mike-rankin/ESP32_VL53L5CX/Images/Board3.jpg

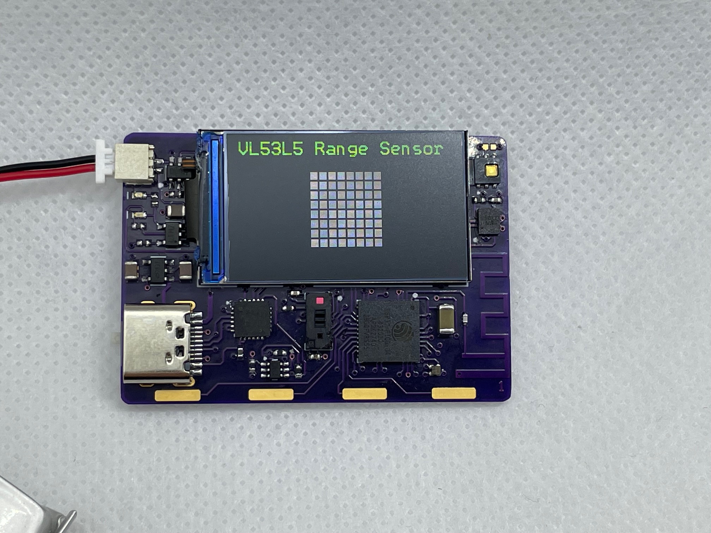
Images/Board3.jpg
