mike-rankin/ESP32_VL53L5CX/Images/Board2.jpg

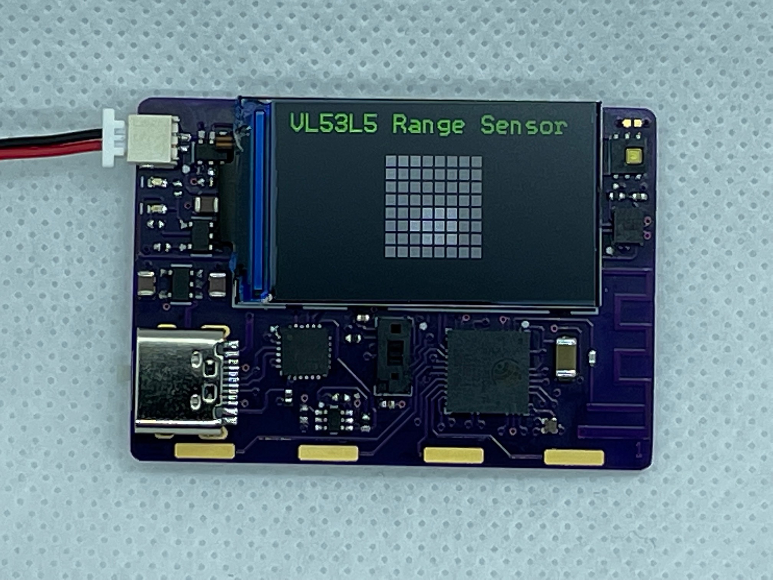
Images/Board2.jpg
