mike-rankin/ESP32_VL53L5CX/README.md

# ESP32_VL53L5CX
Small dev board for the STMicro VL53L5CX Sensor

Board3

The VL53L5CX from STMicro is an interesting multi zone range sensor. I've been using the older VL53L0CX for years as a large distance touchless sensor and range sensor but the new VL53L5CX does the same job but can see the range of several different objects all at the same time broken down into zones. These values can be displayed as pixels showing as a very low resolution camera.

Arduino library here:https://github.com/simondlevy/VL53L5
ESp32 library tweaks needed here: https://github.com/simondlevy/VL53L5/issues/5

Zones

Zones2

See a video of it in action here:https://youtu.be/wSQc9fxhErk
