mike-rankin/ESP32_VL53L5CX/Images/Board1.jpg

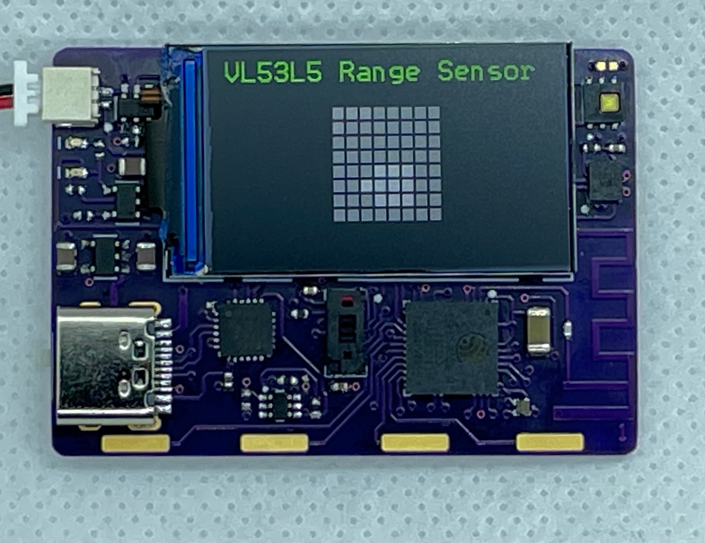
Images/Board1.jpg
