mike-rankin/ESP32_VL53L5CX/Images/VL53L5CX.jpg

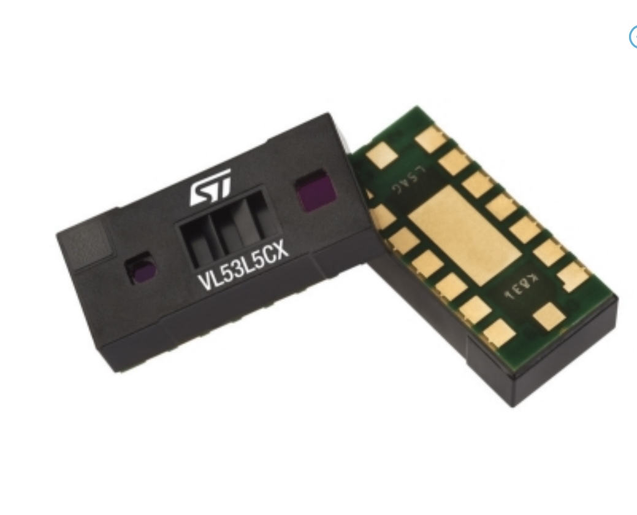
Images/VL53L5CX.jpg
