mike-rankin/ESP32_VL53L5CX/Images/Zones2.jpg

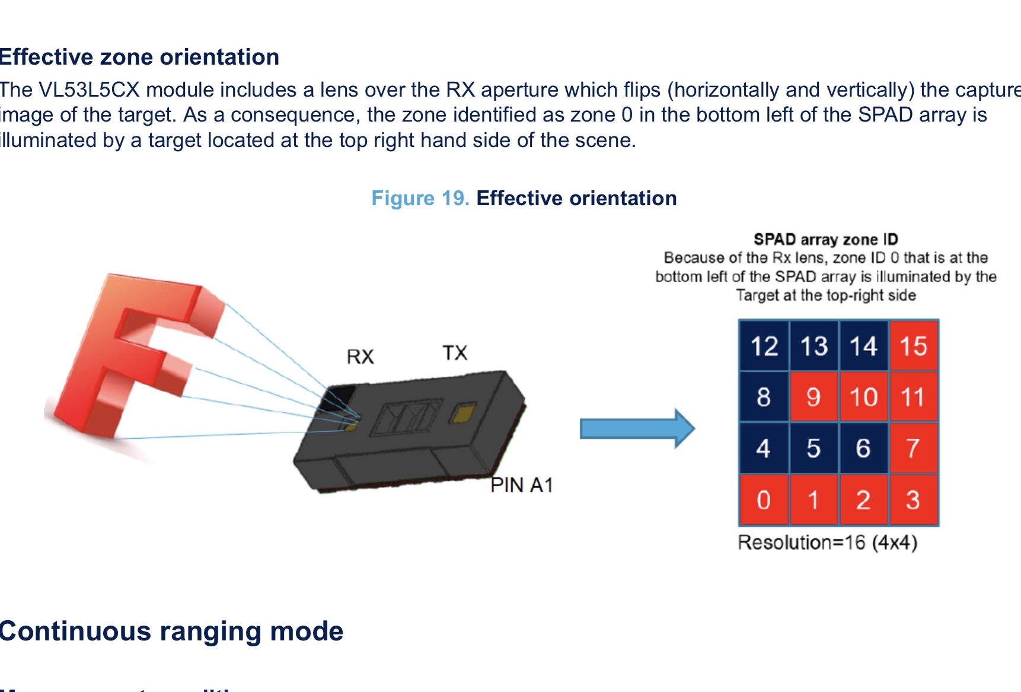
Images/Zones2.jpg
