mike-rankin/ESP32_VL53L5CX/Images/Zones.jpg

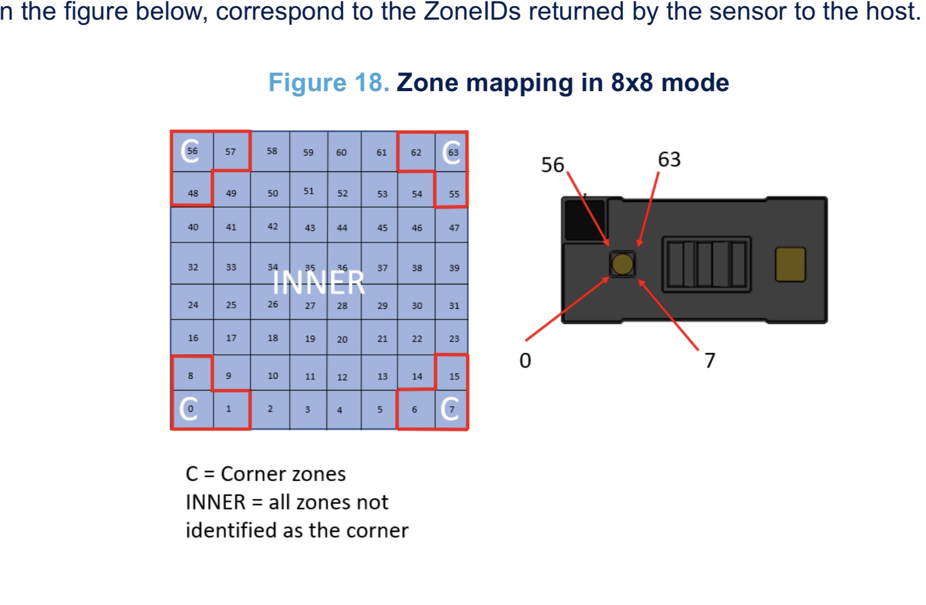
Images/Zones.jpg
