mike-rankin/ESP32_VL53L5CX/PCB/Parts_List_Rev1.xlsx

Designator | Quantity | Vendor | PartNumber | Description | Manufacturer | Value
C1, C2, C4, C5, C10, C14, C19 | 7 | LCSC | C344190 | CAP 0.1uF 0402 | CCTC | 0.1uF
C3 | 1 | LCSC | C147344 | CAP 1.5pF 0402 | Dafron | 1.5pF
C6 | 1 | LCSC | C87164 | CAP 100uF 6.3V 1206 | Taiyo Yuden | 100uF
C7, C9, C13, C15 | 4 | LCSC | C307520 | CAP 10uF 0805 | Samsung | 10uF
C8 | 1 | LCSC | C385897 | CAP 4.7uF 0805 | Taiyo Yunden | 4.7uF
C18 | 1 | LCSC | C83063 | CAP 1uF 16V 0402 | Walsin | 1uF
D1 | 1 | LCSC | C475717 | DIODE SCHOTTKY 20V 500MA SOD123 | CJ | MBR0520
D2 | 1 | LCSC | C364556 | LED RED 0603 |  | Red Led
D3 | 1 | LCSC | C158099 | LED,RGB LED,SMD,RoHS | Foshan | RGB Led
D4 | 1 | LCSC | C74338 | LED Green 0402 |  | Green Led
J2 | 1 | LCSC | C165948 | CONN RECPT USB-C | KHE | USB-C
Q1 | 1 | LCSC | BC847S | TRANS 2NPN 44V 0.1A SC-70-6 | Changjiang | 2NPN
Q2 | 1 | LCSC | C75469 | MOSFET P-CH 20V 2A SOT-23 | On Semi | Mosfet P-CH
Q3 | 1 | LCSC | C668969 | TRANSISTOR NPN SOT23 | Micro Commercial | MMBT3904-TP
Q4 | 1 | LCSC | C16052 | MOSFET 2N-CH 20V 6A TSSOP-8L | Fortune | FS8205A
R1, R3, R5, R6, R7, R19 | 6 | LCSC | C258091 | RES 10K 0402 | Guangdong | 10K
R2, R8, R9, R10, R20 | 5 | LCSC | C106235 | RES 1K 0402 | Yageo | 1K
R4 | 1 | LCSC | C8329 | RES 43K 0402 | Uniroyal | 43K
R11 | 1 | LCSC | C25741 | RES 100K 0402 | Uniroyal Elec | 100K
R12, R13 | 2 | LCSC | C100291 | RES 2K 0402 | LIZ Elec | 2K
R14 | 1 | LCSC | C100139 | RES 4.7K 0402 | LIZ Elec | 4.7K
R15 | 1 | LCSC | C25092 | RES 22R 0402 | Uniroyal | 22R
R16, R18 | 2 | LCSC | C965250 | RES 5.1K 0402 | Uni-Royal | 5.1K
R17 | 1 | LCSC | C106232 | RES 100R 0402 | Yageo | 100R
R21 | 1 | LCSC | C100310 | RES 22K 0402 | LIZ Elec | 22K
R22, R23, R24, R25 | 4 | LCSC | C25792 | RES 47K 0402 | Uni-Royal | 47K
S1 | 1 | LCSC | C128955 | SWITCH SLIDE SMD | Korean Hroparts Elec | SWITCH SLIDE
U1 | 1 | LCSC | C47742 | IC BRIDGE USB TO UART 24QFN | Silicon Labs | CP2104N
U2 | 1 | LCSC | C193707 | RF Transceiver ICs QFN-48_7x7x05P RoHS | Espressif | ESP32-PICO-D4
U4 | 1 | LCSC | C164106 | IC LDO 3.3V 0.5A SOT23-5 | Holtek | HT7833
U5 | 1 | LCSC | C258510 | Charger IC Lithium-Ion/Polymer SOT23-5 | Techfuse | SL4054ST25P
U6 | 1 | LCSC | LSM6DS3TR | IMU ACCEL/GYRO I2C/SPI 14VFLGA | ST MICRO | LSM6DS3
U7 | 1 | LCSC | C82227 | Humidity/Temperature Sensor | Texas Instruments | HDC1080DMBT
U8 | 1 | LCSC | C351410 | IC LITHIUM BATT PROTECT SOT-23-6L | PUOLOP | DW01A
U9 | 1 | Digi-Key | VL53L5CXV0GC/1 | IC,LASER SENSOR,17pin | ST MICRO | VL53L5CX
X1 | 1 | BuyDisplay | ER-TFT1.14-1 | 1.14 INCH TFT GLASS COLOR | BuyDisplay | TFT_1.14"
