mike-rankin/ESP32_VL53L5CX/PCB/Schematic_Rev1.pdf

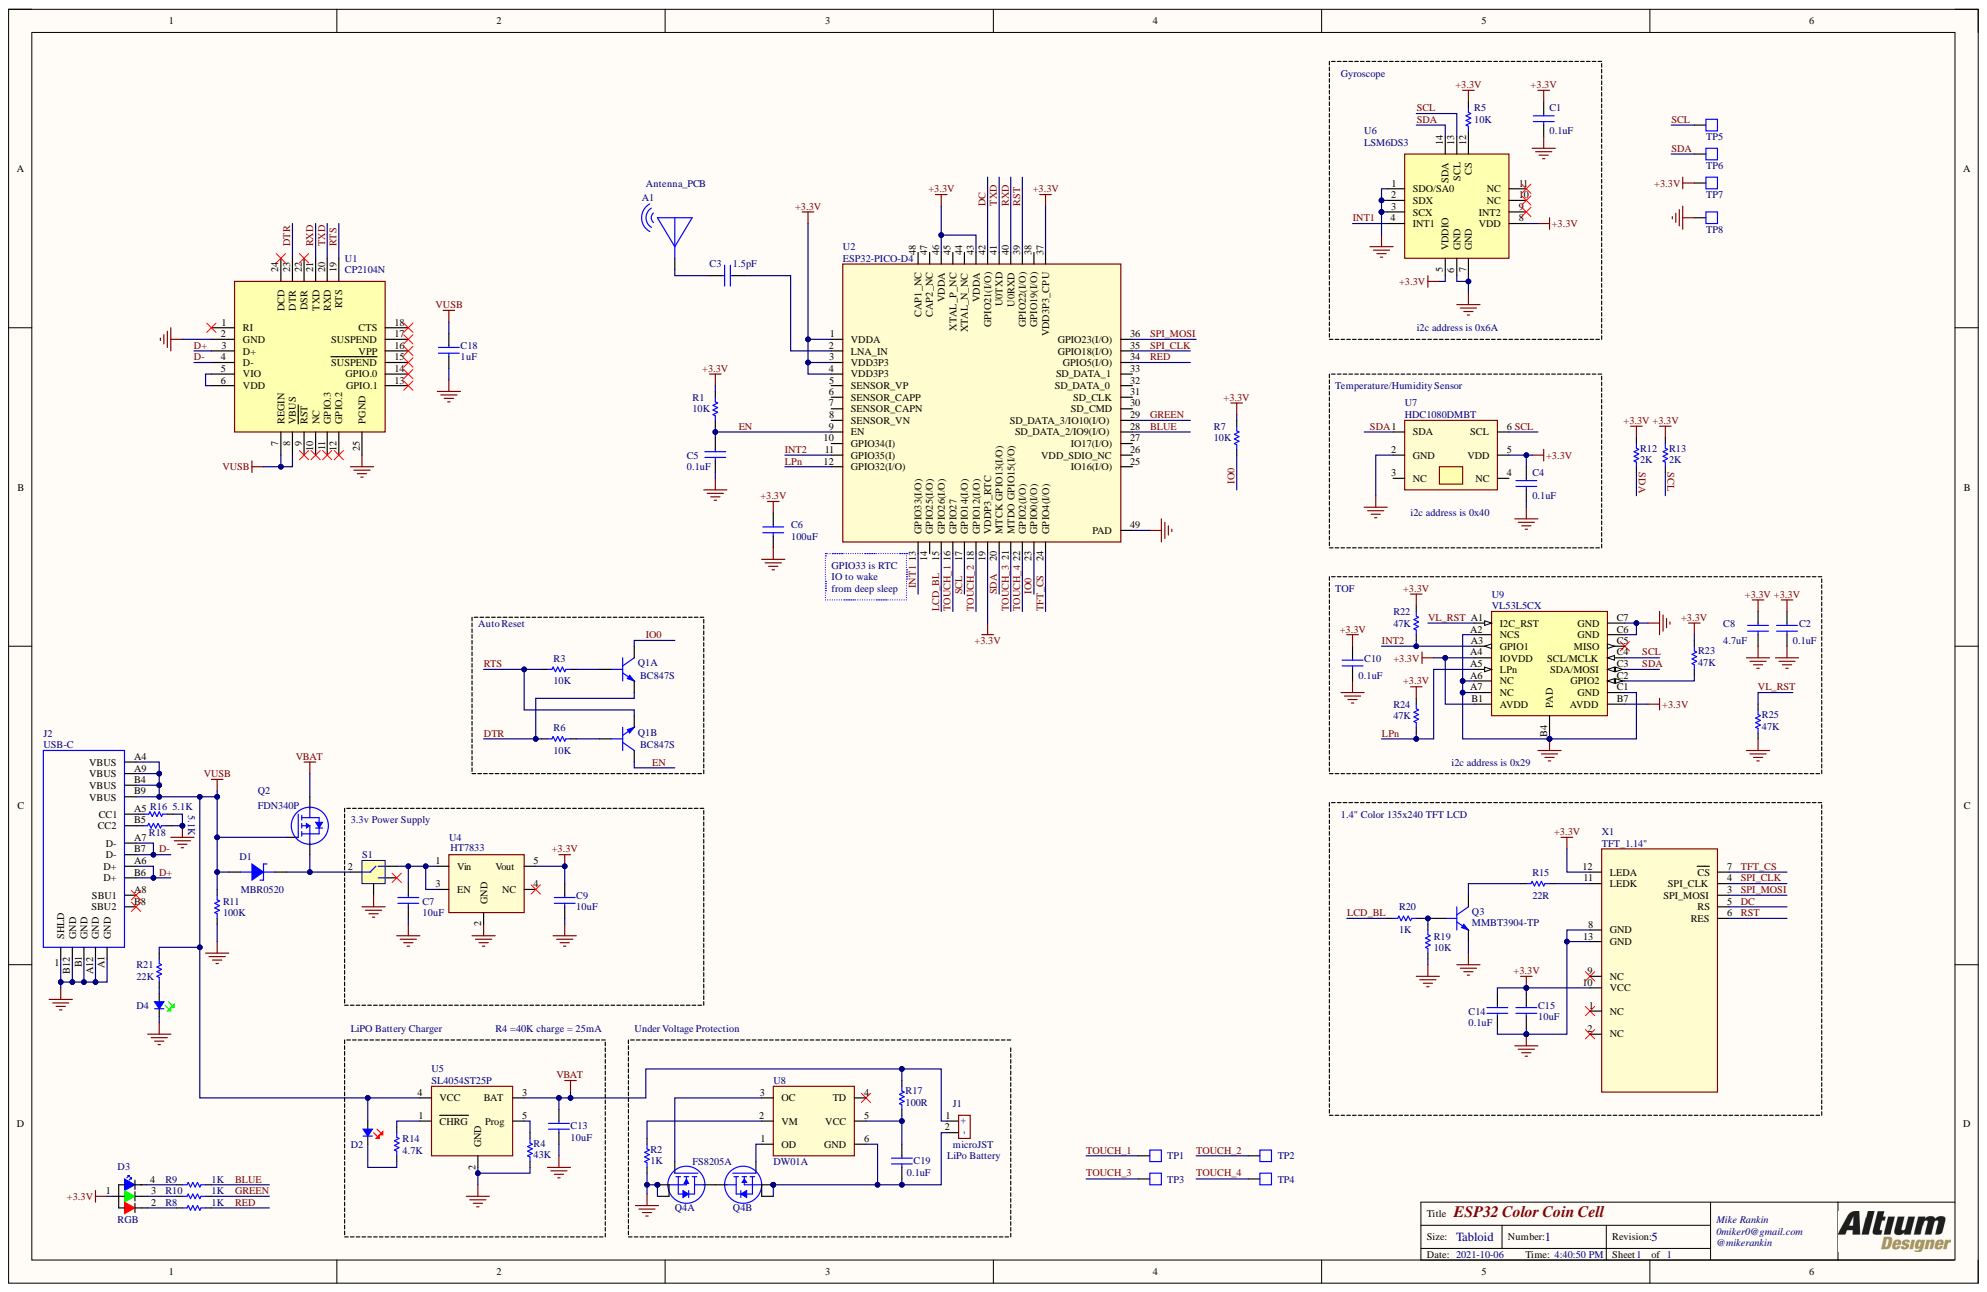
[picture p7: page 1]

RTS 19 RXD 20 TXD 21 DSR 22 DTR 23

GPIO1 A3
IOVDD A4
LPn A5

+3.3V 47K LPn | | | NC A6

NC A7 AVDD B1
