mike-rankin/ESP32_VL53L5CX/(commit log)

2021-10-07 Adding schematic and code examples
2021-10-18 Added parts list
    [Parts_List_Rev1.xlsx]
